Jana-Marie/USB-LED-Otter/README.md

# USB-LED-Otter
The tiny USB to adressable LED adapter that fits in your USB port :3

## Usage

    $ cd USB-LED-Otter-FW
    $ make
    $ dfu-util -a 0 -s 0x08000000:leave -D build/firmware.bin

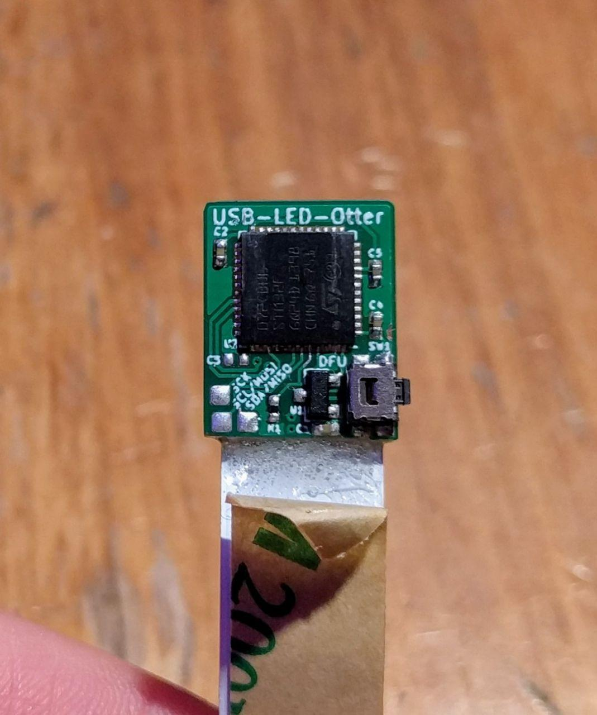
[picture p1: images/rl1.jpg]

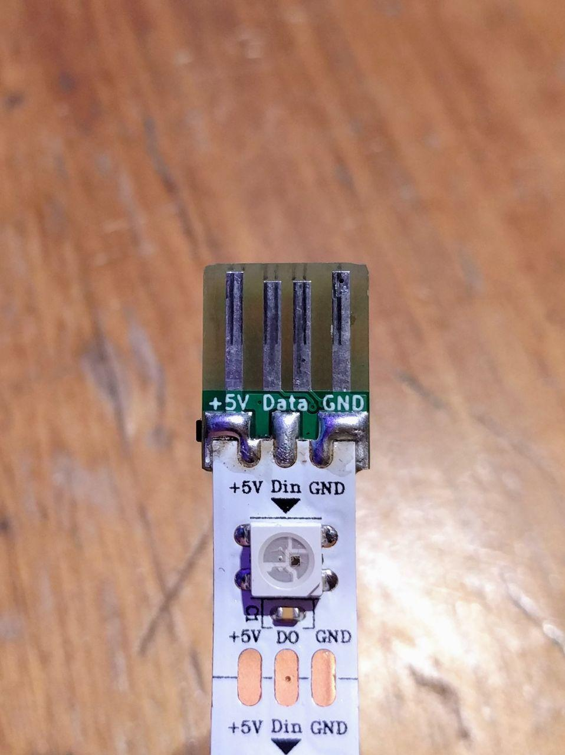
[picture p2: images/rl2.jpg]

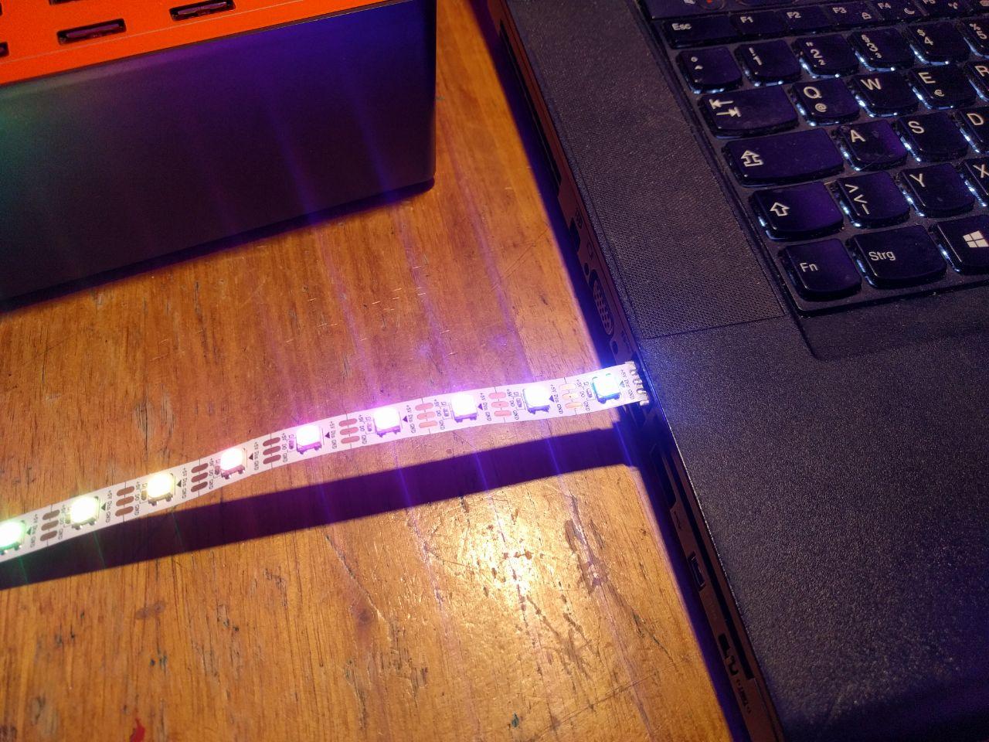
[picture p3: images/rl3.jpg]

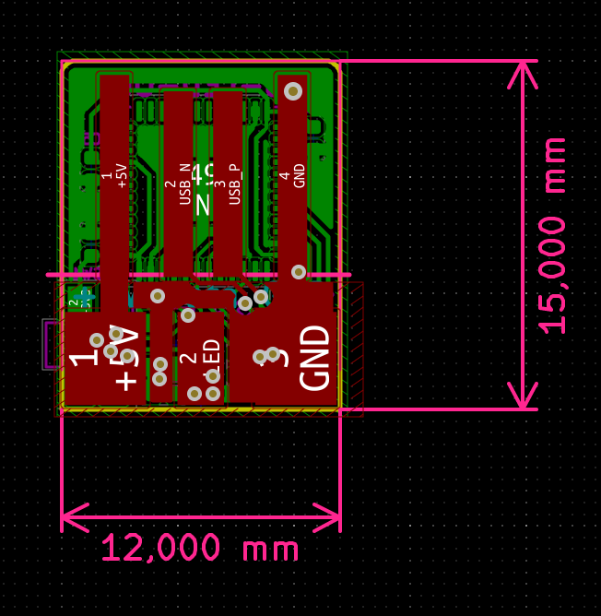
[picture p4: images/PCB.png]
