Jana-Marie/USB-LED-Otter/images/3D1.png

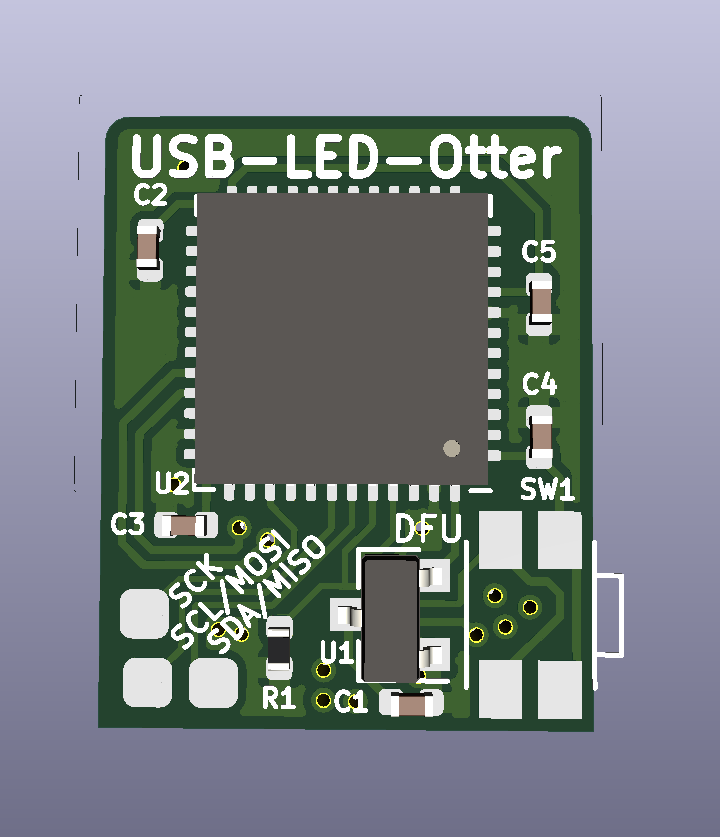
images/3D1.png
