Jana-Marie/USB-LED-Otter/images/3D2.png

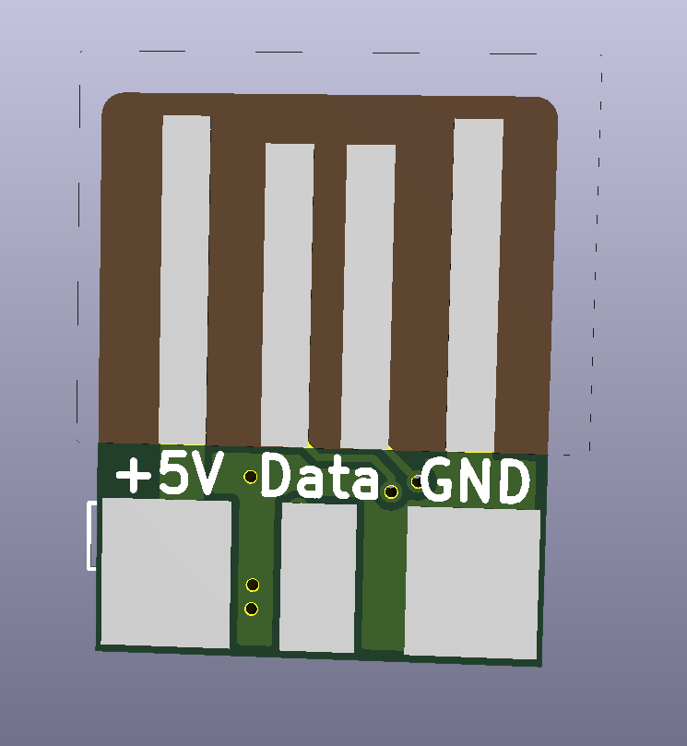
images/3D2.png
