Jana-Marie/USB-LED-Otter/USB-LED-Otter.kicad_pcb

## KiCad design USB-LED-Otter.kicad_pcb (2019-12-13)

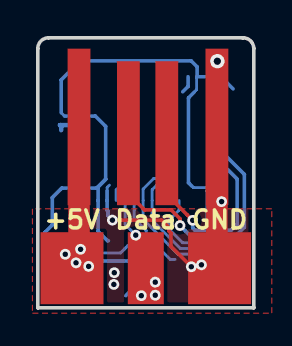
[picture p7: board USB-LED-Otter.kicad_pcb from above]

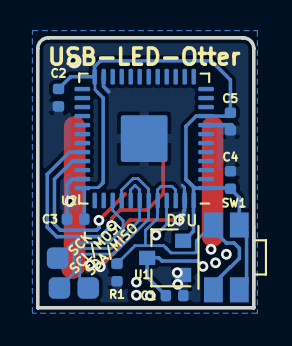
[picture p8: board USB-LED-Otter.kicad_pcb from below]

Board: 2 copper layers, 12.0 x 15.0 mm, 14 parts (12 on the bottom side), 10 nets.

Parts:
C1, C2, C3, C4, C5: 100n; C_0402_1005Metric
J1: USB; USBPCB
J2, J4, J5: PAD; Pad_0.80.8
J3: LED; LED-Strip
R1: 10k; R_0402_1005Metric
SW1: DFU; SW_SPST_EVQP7A
U1: MCP1700-3302E_SOT23; SOT-23
U2: STM32F072CBUx; QFN-48-1EP_7x7mm_P0.5mm_EP2.6x2.6mm

Connections:
+3V3: C2.1, C3.1, C4.1, C5.1, SW1.2, U1.2, U2.1, U2.9, U2.24, U2.36, U2.48
+5V: C1.1, J1.1, J3.1, U1.3
GND: C1.2, C2.2, C3.2, C4.2, C5.2, J1.4, J3.3, R1.2, U1.1, U2.8, U2.23, U2.35, U2.47, U2.49
LED: J3.2, U2.45
unnamed: R1.1, SW1.1, U2.44, U2.46
SCK: J5.1, U2.39
SCL: J2.1, U2.41, U2.42
SDA: J4.1, U2.40, U2.43
USB_N: J1.2, U2.32
USB_P: J1.3, U2.33
