Jana-Marie/USB-LED-Otter/USB-LED-Otter-FW/Src/main.c

#include "main.h"
#include "sk6812.h"
#include "defines.h"

TIM_HandleTypeDef htim16;
DMA_HandleTypeDef hdma_tim16_ch1_up;

PCD_HandleTypeDef hpcd_USB_FS;

void SystemClock_Config(void);
static void MX_GPIO_Init(void);
static void MX_DMA_Init(void);
static void MX_TIM16_Init(void);
static void MX_USB_PCD_Init(void);

extern uint16_t write_buffer[LED_BUFFER_SIZE];
hsv otter;

int main(void)
{
  HAL_Init();
  SystemClock_Config();

  MX_GPIO_Init();
  MX_DMA_Init();
  MX_TIM16_Init();
  MX_USB_PCD_Init();
  HAL_TIM_PWM_Start_DMA(&htim16, TIM_CHANNEL_1, write_buffer, LED_BUFFER_SIZE);
  otter.h = 0;
  otter.s = 1.0;
  otter.v = 1.0;

  while (1)
  {
    for(int i = 0; i <= 11; i++){

      otter.h = (int)((i*30) + (HAL_GetTick()/2))%360;
      otter.s = 1.0;
      otter.v = 0.3;
      set_pixel(i,hsv2rgb(otter),write_buffer);

      /*
      otter.h = (int)((HAL_GetTick()/30))%360;
      otter.s = 1.0;
      otter.v = 0.5;
      set_pixel(i,hsv2rgb(otter),write_buffer);
      */
    }
  }
}

void SystemClock_Config(void)
{
  RCC_OscInitTypeDef RCC_OscInitStruct = {0};
  RCC_ClkInitTypeDef RCC_ClkInitStruct = {0};
  RCC_PeriphCLKInitTypeDef PeriphClkInit = {0};

  RCC_OscInitStruct.OscillatorType = RCC_OSCILLATORTYPE_HSI48;
  RCC_OscInitStruct.HSI48State = RCC_HSI48_ON;
  RCC_OscInitStruct.PLL.PLLState = RCC_PLL_NONE;
  HAL_RCC_OscConfig(&RCC_OscInitStruct);

  RCC_ClkInitStruct.ClockType = RCC_CLOCKTYPE_HCLK|RCC_CLOCKTYPE_SYSCLK
                              |RCC_CLOCKTYPE_PCLK1;
  RCC_ClkInitStruct.SYSCLKSource = RCC_SYSCLKSOURCE_HSI48;
  RCC_ClkInitStruct.AHBCLKDivider = RCC_SYSCLK_DIV1;
  RCC_ClkInitStruct.APB1CLKDivider = RCC_HCLK_DIV1;

  HAL_RCC_ClockConfig(&RCC_ClkInitStruct, FLASH_LATENCY_1);
  PeriphClkInit.PeriphClockSelection = RCC_PERIPHCLK_USB;
  PeriphClkInit.UsbClockSelection = RCC_USBCLKSOURCE_HSI48;

  HAL_RCCEx_PeriphCLKConfig(&PeriphClkInit);
}

static void MX_TIM16_Init(void)
{
  TIM_OC_InitTypeDef sConfigOC = {0};
  TIM_BreakDeadTimeConfigTypeDef sBreakDeadTimeConfig = {0};

  htim16.Instance = TIM16;
  htim16.Init.Prescaler = 0;
  htim16.Init.CounterMode = TIM_COUNTERMODE_UP;
  htim16.Init.Period = LED_PER;
  htim16.Init.ClockDivision = TIM_CLOCKDIVISION_DIV1;
  htim16.Init.RepetitionCounter = 0;
  htim16.Init.AutoReloadPreload = TIM_AUTORELOAD_PRELOAD_DISABLE;
  HAL_TIM_Base_Init(&htim16);
  HAL_TIM_PWM_Init(&htim16);

  sConfigOC.OCMode = TIM_OCMODE_PWM1;
  sConfigOC.Pulse = 20;
  sConfigOC.OCPolarity = TIM_OCPOLARITY_HIGH;
  sConfigOC.OCNPolarity = TIM_OCNPOLARITY_HIGH;
  sConfigOC.OCFastMode = TIM_OCFAST_DISABLE;
  sConfigOC.OCIdleState = TIM_OCIDLESTATE_RESET;
  sConfigOC.OCNIdleState = TIM_OCNIDLESTATE_RESET;
  HAL_TIM_PWM_ConfigChannel(&htim16, &sConfigOC, TIM_CHANNEL_1);

  sBreakDeadTimeConfig.OffStateRunMode = TIM_OSSR_DISABLE;
  sBreakDeadTimeConfig.OffStateIDLEMode = TIM_OSSI_DISABLE;
  sBreakDeadTimeConfig.LockLevel = TIM_LOCKLEVEL_OFF;
  sBreakDeadTimeConfig.DeadTime = 0;
  sBreakDeadTimeConfig.BreakState = TIM_BREAK_DISABLE;
  sBreakDeadTimeConfig.BreakPolarity = TIM_BREAKPOLARITY_HIGH;
  sBreakDeadTimeConfig.BreakFilter = 0;
  sBreakDeadTimeConfig.AutomaticOutput = TIM_AUTOMATICOUTPUT_DISABLE;
  HAL_TIMEx_ConfigBreakDeadTime(&htim16, &sBreakDeadTimeConfig);

  HAL_TIM_MspPostInit(&htim16);

}

static void MX_USB_PCD_Init(void)
{

  hpcd_USB_FS.Instance = USB;
  hpcd_USB_FS.Init.dev_endpoints = 8;
  hpcd_USB_FS.Init.speed = PCD_SPEED_FULL;
  hpcd_USB_FS.Init.phy_itface = PCD_PHY_EMBEDDED;
  hpcd_USB_FS.Init.low_power_enable = DISABLE;
  hpcd_USB_FS.Init.lpm_enable = DISABLE;
  hpcd_USB_FS.Init.battery_charging_enable = DISABLE;
  HAL_PCD_Init(&hpcd_USB_FS);
}

static void MX_DMA_Init(void)
{

  __HAL_RCC_DMA1_CLK_ENABLE();

  HAL_NVIC_SetPriority(DMA1_Channel2_3_IRQn, 0, 0);
  HAL_NVIC_EnableIRQ(DMA1_Channel2_3_IRQn);

}

static void MX_GPIO_Init(void)
{
  GPIO_InitTypeDef GPIO_InitStruct = {0};

  __HAL_RCC_GPIOA_CLK_ENABLE();
  __HAL_RCC_GPIOB_CLK_ENABLE();

  GPIO_InitStruct.Pin = GPIO_PIN_9;
  GPIO_InitStruct.Mode = GPIO_MODE_INPUT;
  GPIO_InitStruct.Pull = GPIO_NOPULL;
  HAL_GPIO_Init(GPIOB, &GPIO_InitStruct);

}

void Error_Handler(void)
{
  while (1)
  {
  }
}
