Jana-Marie/USB-LED-Otter/USB-LED-Otter-FW/USB-LED-Otter-FW.ioc

Mcu.UserName=STM32F072CBUx
PA11.Signal=USB_DM
PA12.Signal=USB_DP
PB8.GPIO_Label=LED_Out
PB8.Signal=S_TIM16_CH1
PB9.Signal=GPIO_Input
