Jana-Marie/USB-LED-Otter/USB-LED-Otter-FW/Inc/defines.h

#define LED_BUFFER_SIZE   ((12*24) + 42)
#define LED_PER 59
#define LED_CMPH 34
#define LED_CMPL 16
