Jana-Marie/USB-LED-Otter/(commit log)

2019-11-18 added gerber+images
    [USB-LED-Otter-B_Cu.gbl, USB-LED-Otter-B_Mask.gbs, USB-LED-Otter-B_Paste.gbp, USB-LED-Otter-B_SilkS.gbo, USB-LED-Otter-Edge_Cuts.gm1, USB-LED-Otter-F_Cu.gtl, USB-LED-Otter-F_Mask.gts, USB-LED-Otter-F_Paste.gtp]
2019-12-13 added example code
    [USB-LED-Otter-B_Cu.gbl, USB-LED-Otter-B_Mask.gbs, USB-LED-Otter-B_Paste.gbp, USB-LED-Otter-B_SilkS.gbo, USB-LED-Otter-Edge_Cuts.gm1, USB-LED-Otter-F_Cu.gtl, USB-LED-Otter-F_Mask.gts, USB-LED-Otter-F_Paste.gtp]
2019-12-13 remove footprint cache
2019-12-13 add .gitignore via `curl https://gitignore.io/api/kicad`
2019-12-13 Adding KiCAD-libs as submodule
2019-12-13 Adding relative paths to symbol, footprint libraries
2019-12-21 added bom
    [BOM.csv, USB-LED-Otter.sch]
